saitejaswi06/Buck-Boost-Converter/buck_boost_report.pdf

Objective:
Design, fabrication, implementation of a 150 W, 100 V to 230 V and 100 V to 50V, 20 kHz Buck-Boost converter.
Vin = 100V
Vo = (Vin x D )/(1-D)
Step up from 100 V to 230 V ➔ D=23/33=69.7% Step down from 100V to 50V ➔ D=1/3=33.33%

Component Design

Component | Value | Voltage rating | Current rating
Inductor | 4 mH | | 5A
Capacitor | 20uF | 250V
Switch | MOSFET IRF740 | 400V | 10A
Diode | MUR860 | Vr=600V, Vf=1.5V | If=8A, Ir=10uA

Simulation and component selection:
- Simulation-based verification of the component ratings is done to ensure feasibility before fabrication.
- identified key components, including MOSFETs, Diodes, Inductors, and Capacitors, based on desired voltage and current ratings.
- Circuit layout using MATLAB feasibility before fabrication

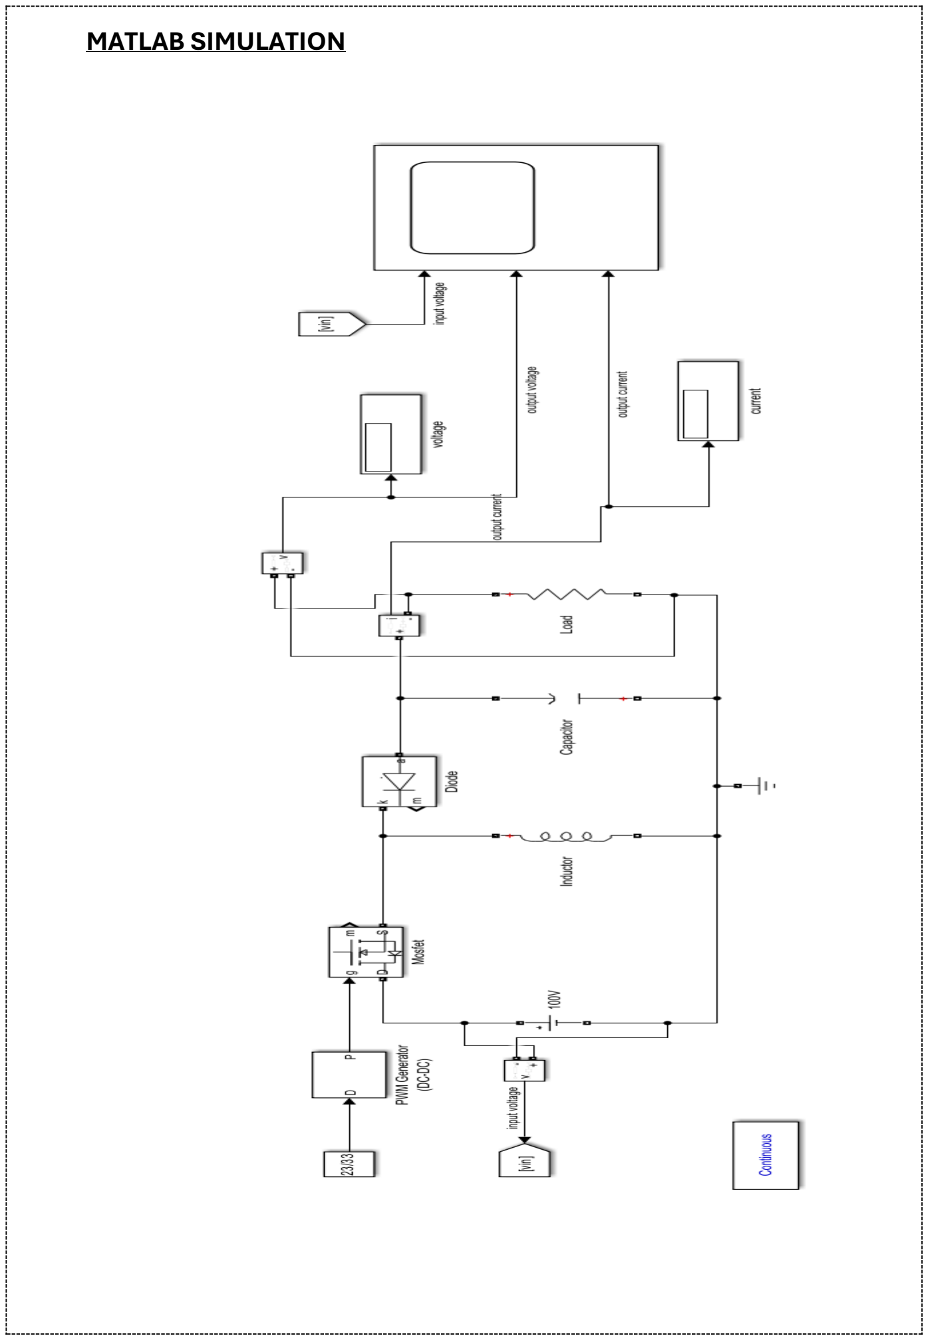
[picture p1: page 2]

MATLAB SIMULATION

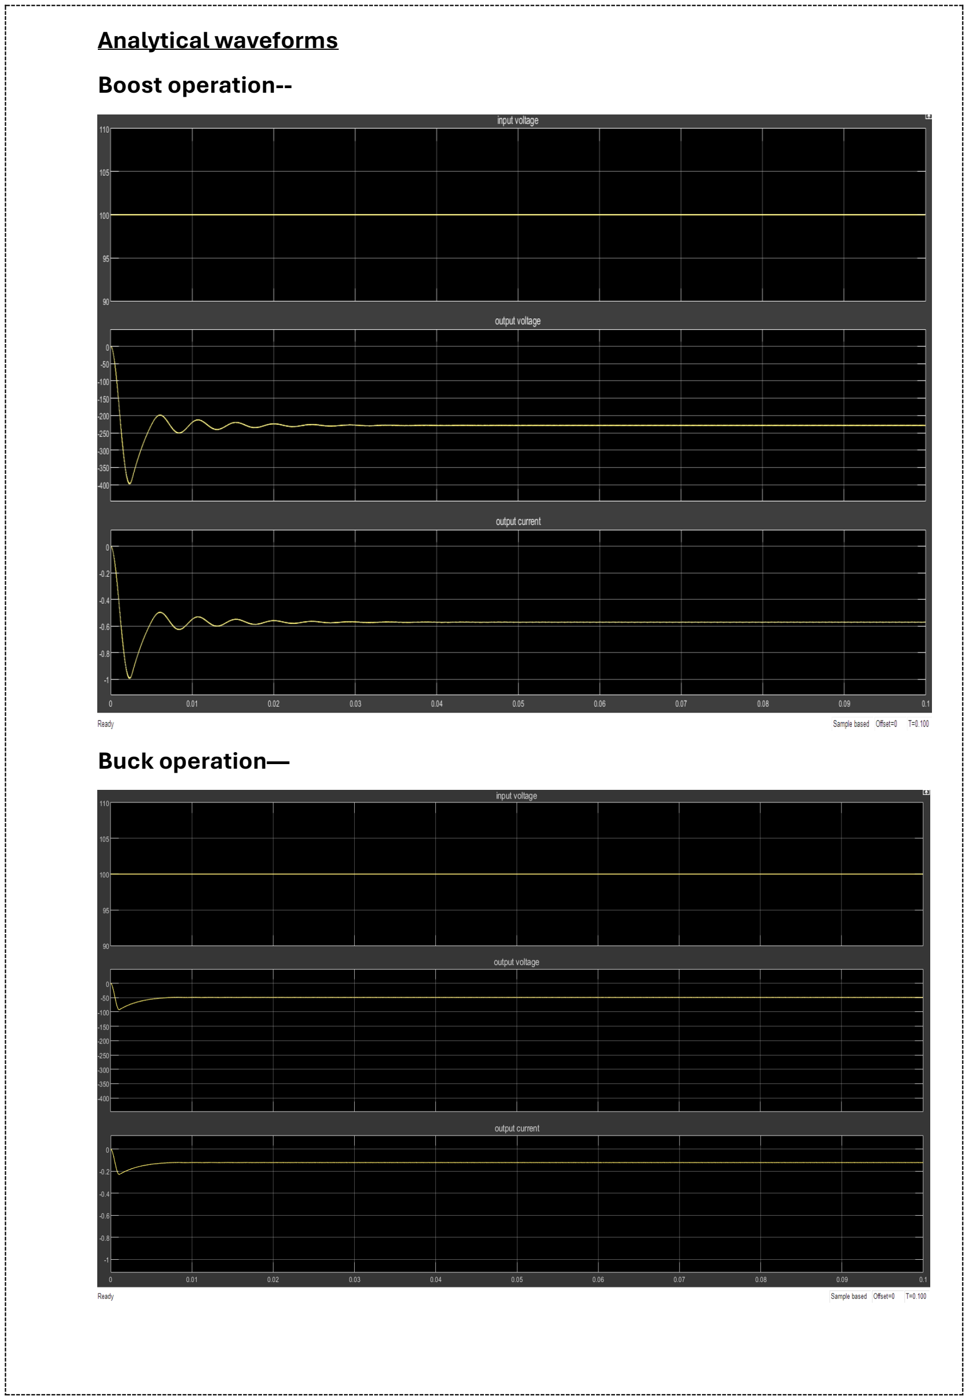
[picture p2: page 3]

Analytical waveforms
Boost operation--

Buck operation—

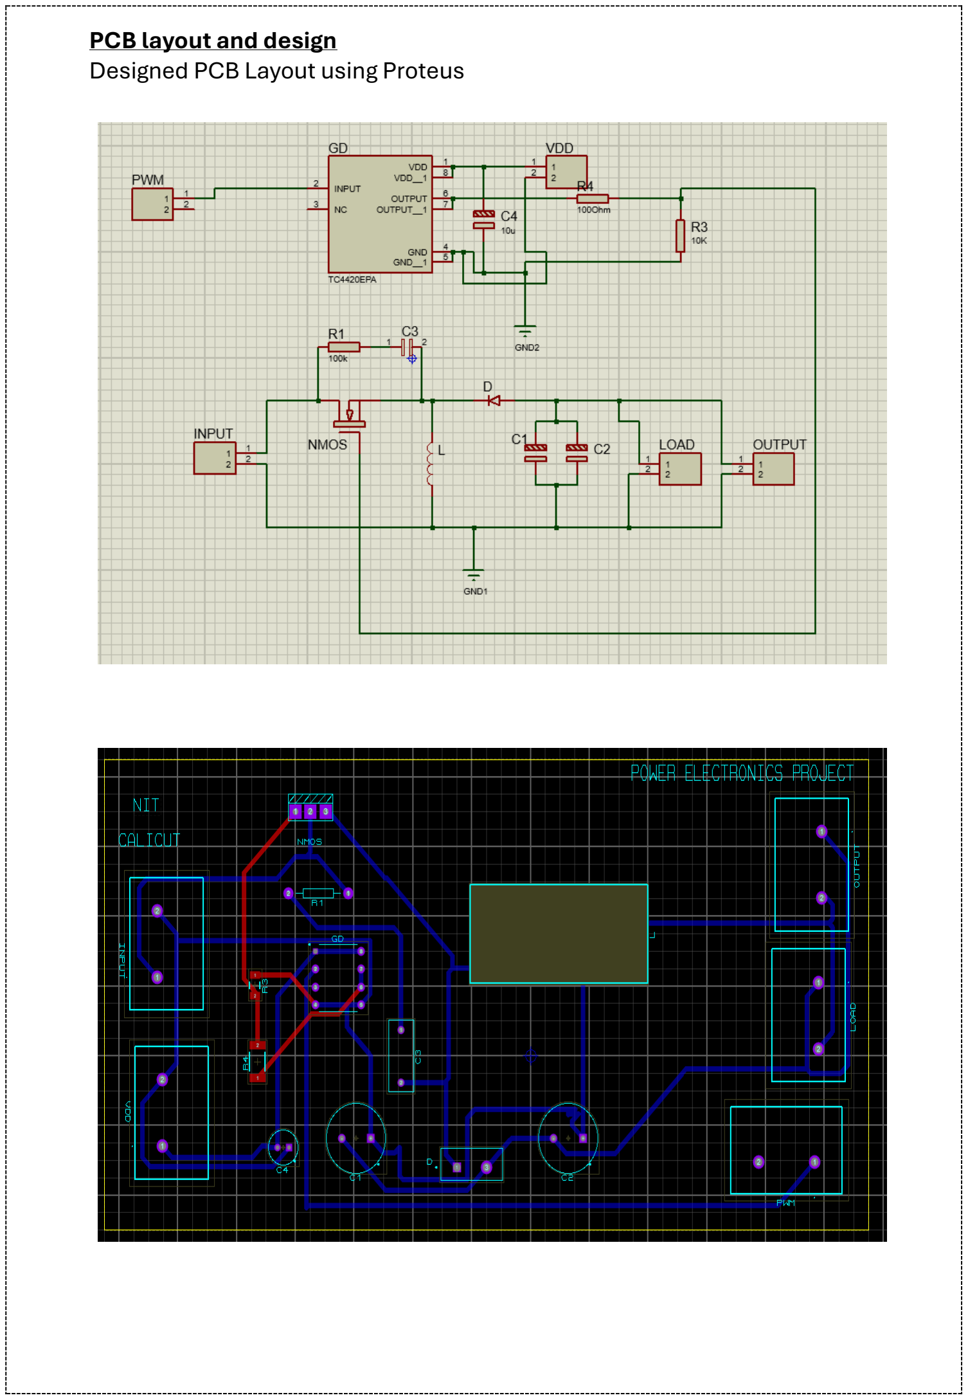
[picture p3: page 4]

PCB layout and design
Designed PCB Layout using Proteus

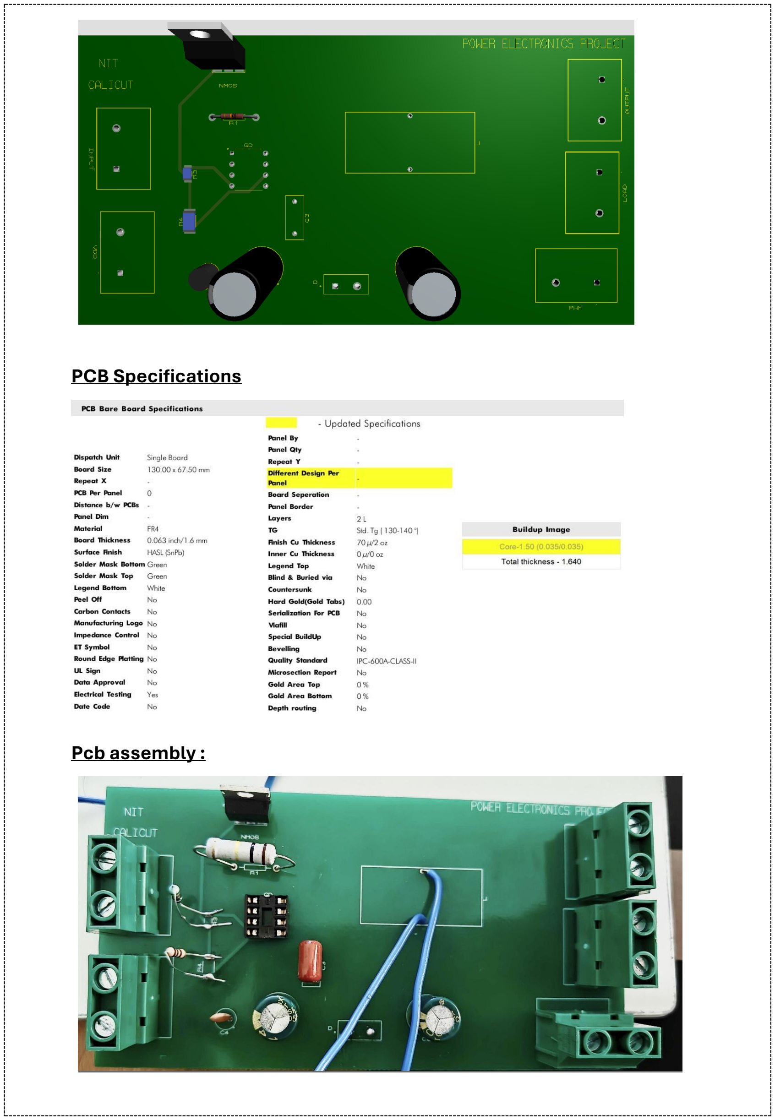
[picture p4: page 5]

PCB Specifications

Pcb assembly :

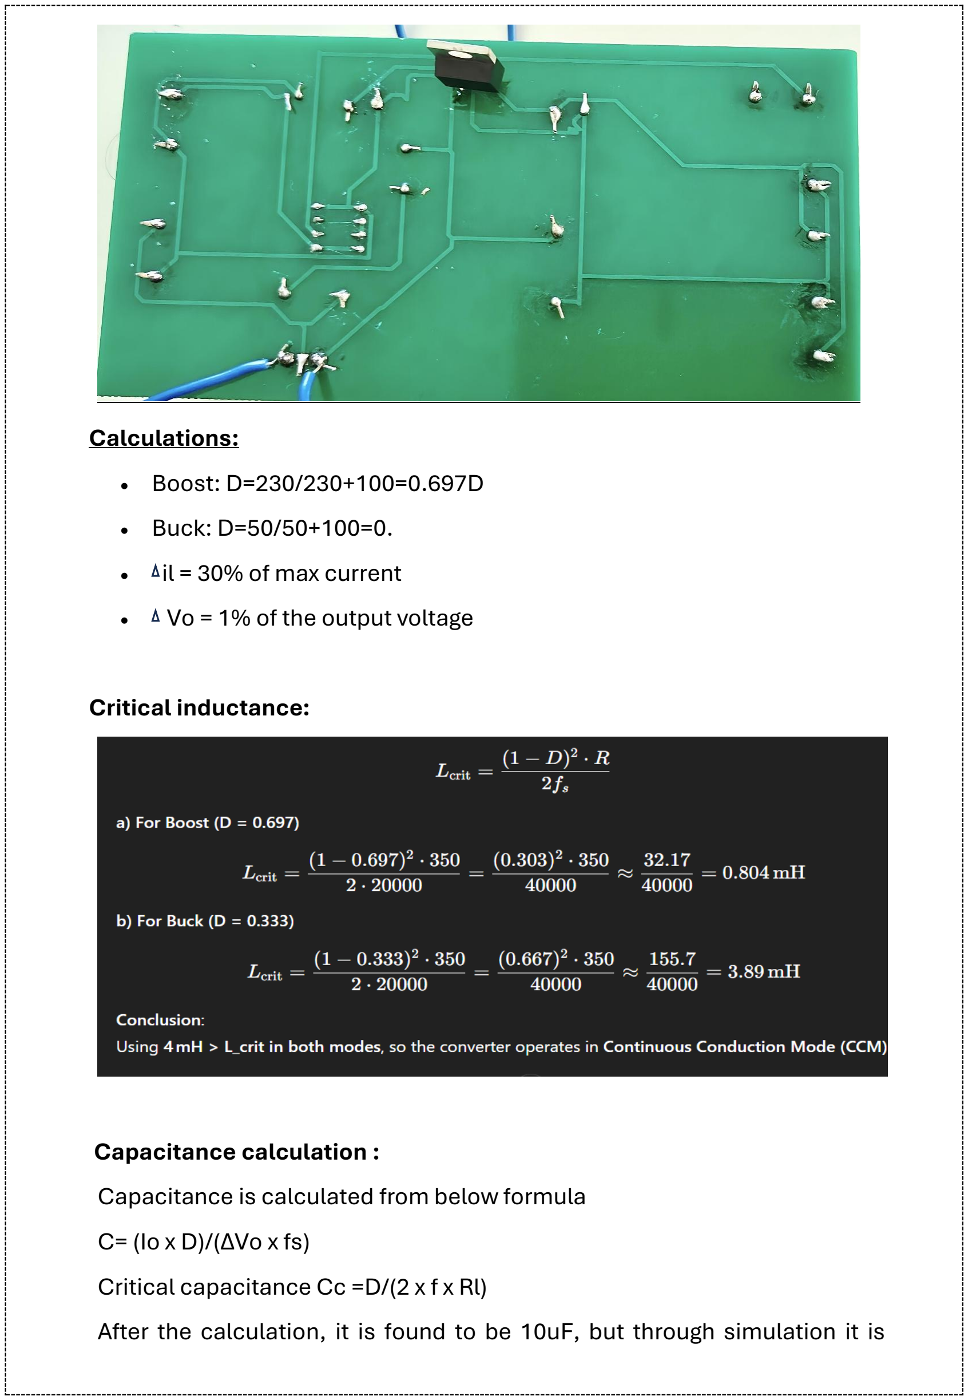
[picture p5: page 6]

Calculations:
- Boost: D=230/230+100=0.697D
- Buck: D=50/50+100=0.
- il = 30% of max current
- Vo = 1% of the output voltage

Critical inductance:

Capacitance calculation :
Capacitance is calculated from below formula
C= (Io x D)/(ΔVo x fs)
Critical capacitance Cc =D/(2 x f x Rl)
After the calculation, it is found to be 10uF, but through simulation it is chosen to be 20uF for better accuracy

Component Ordering:
NMOS | -IRF740
Diode | -MUR860
Gate Driver -TLP250
RC snubber -100kΩ(carbon film) + 0.1uF (ceramic capacitor)
Inductor | - 4mH
Capacitor | - 20uf, 400v(electrolytic capacitors)
Load resistor - 350Ω

Micro Controller for gate pulse:
Arduino Uno R3:
- Used Timer1 in Phase Correct PWM mode.
- PWM frequency ~20 kHz.
- Oscilloscope used to verify PWM pulse width and frequency.
- Generated pulses at output pins 9 and 10
Code for pulse generation:
void setup() {
// Set D9 and D10 as output
pinMode(9, OUTPUT);
pinMode(10, OUTPUT);

// Stop Timer1
TCCR1A = 0;
TCCR1B = 0;
TCNT1 = 0;

// Set Fast PWM mode with ICR1 as TOP
// WGM13:WGM10 = 14 => Fast PWM with ICR1 as TOP
TCCR1A |= (1 << COM1A1) | (1 << COM1B1); // Non-inverting mode
TCCR1A |= (1 << WGM11);
TCCR1B |= (1 << WGM12) | (1 << WGM13);

// No prescaling (prescaler = 1)
TCCR1B |= (1 << CS10);

// TOP value for 20kHz PWM frequency
ICR1 = 799; // f_PWM = 16MHz / (1 * (1 + 799)) = 20kHz

// Set duty cycles
OCR1A = (ICR1 * 23) / 33; // BOOST duty on D9
OCR1B = (ICR1 * 5) / 15; // BUCK duty on D10

}
void loop() {
}

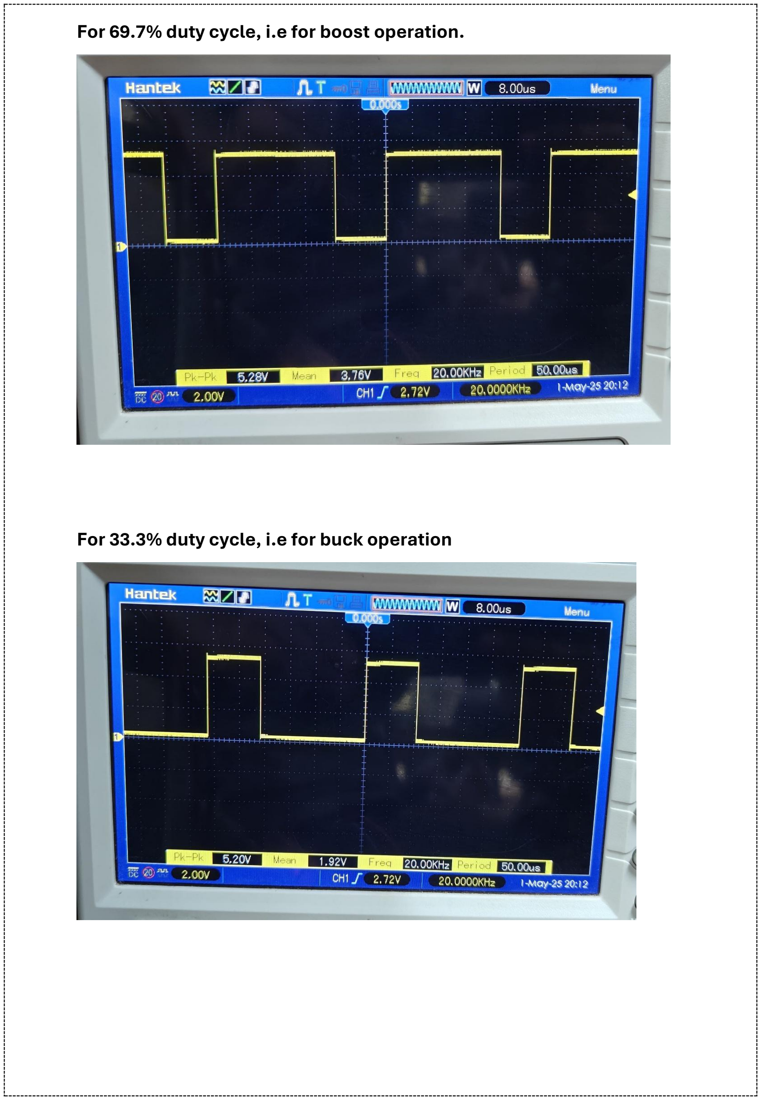
[picture p6: page 8]

For 69.7% duty cycle, i.e for boost operation.

For 33.3% duty cycle, i.e for buck operation

Gate driver design
To drive the IRF740 as a high-side MOSFET, a 15 V gate signal was required— beyond the 5 V logic level provided by the Arduino. The TLP250, an opto-isolated gate driver, was chosen to safely translate 5 V logic to 15 V while providing necessary isolation between the control and power circuits,
making | it | ideal | for | this | high-voltage | application.

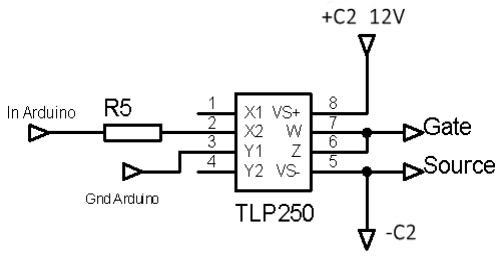
[picture p7: figure]

Gate Resistor (Rg)
Usually 1 resistor per gate – used between the TLP250 output and the MOSFET gate.
Rg=Vdrive/Igate
It is chose to be 100 Ω for reduced EMI losses and proper switching speed

Pull-Down Resistor (Rpd)

Connected between the Gate and Source of the MOSFET.

Typically 10kΩ is used

Bootstrap Capacitor (Cb)
If you're driving a high-side MOSFET (like in a half-bridge), the bootstrap capacitor is used to provide gate voltage above the source.

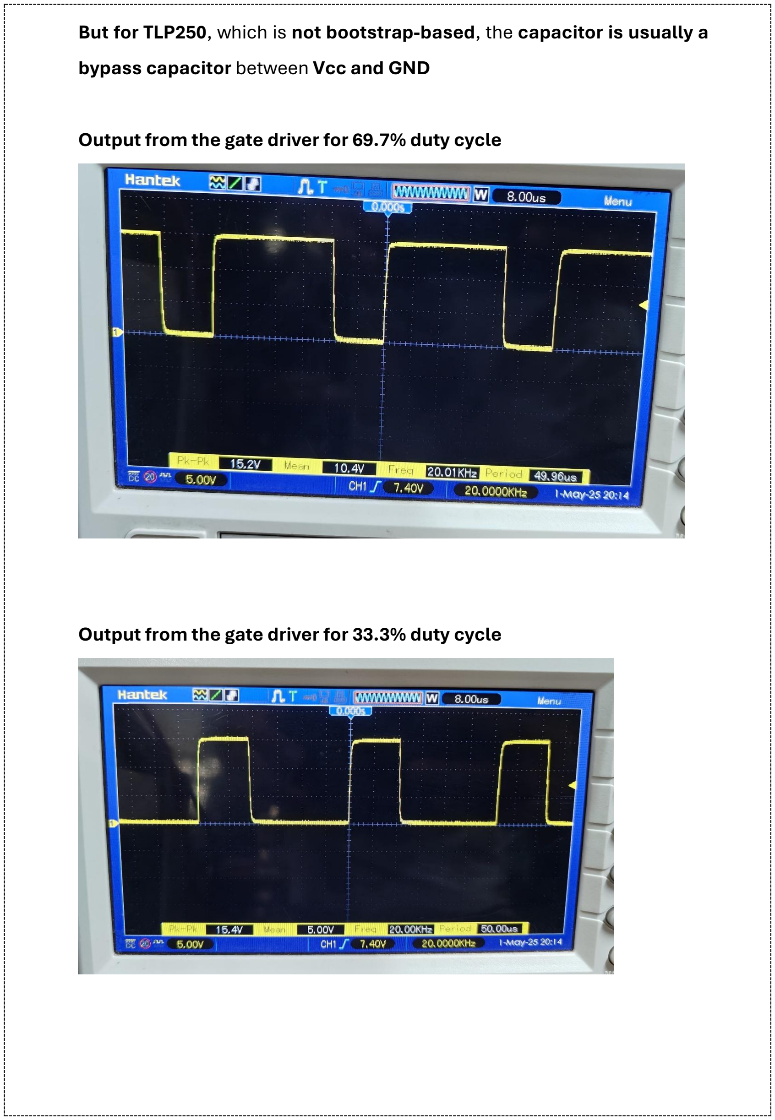
[picture p8: page 10]

But for TLP250, which is not bootstrap-based, the capacitor is usually a bypass capacitor between Vcc and GND

Output from the gate driver for 69.7% duty cycle

Output from the gate driver for 33.3% duty cycle

Inductor Design and Fabrication :
Objective:
Design and fabricate a 4 mH inductor suitable for use in a buck-boost converter operating around 100V input, with capability for both step-up and step-down modes.
L=(μ0⋅μr⋅A⋅N^2)/l

### 1. Core Selection:

Core Type: EE55 ferrite core (MnZn material) chosen for high-frequency performance and minimal core losses.
- Core Parameters:
- A(Effective Area): ~1.5 cm²
- L(Magnetic Path Length): ~8.5 cm
- B: ~0.35 T
- µr: ~2000 (assumed for gapped ferrite)

### 2. Inductance Calculation:

- Target Inductance (L): 4 mH
- Frequency: ~20 kHz
- Estimated Turns (N): ~85–100 turns (adjusted empirically based on actual inductance measured using LCR meter)
- Wire: AWG 20 enameled copper wire (current rating ~1.5–2A continuous)

### 3. Saturation Current Check:

With the gapped core, a saturation current of around 1.5–2 A was achieved, which was within expected limits for the converter's operation.

### 4. Fabrication:

- Winding: 90 turns of AWG20 wire.

### Result:

Boost operation

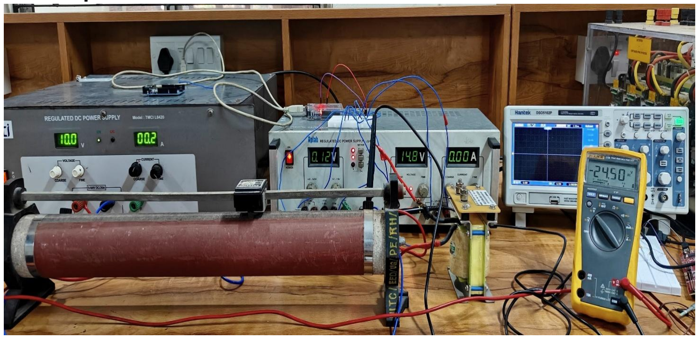
[picture p9: figure]
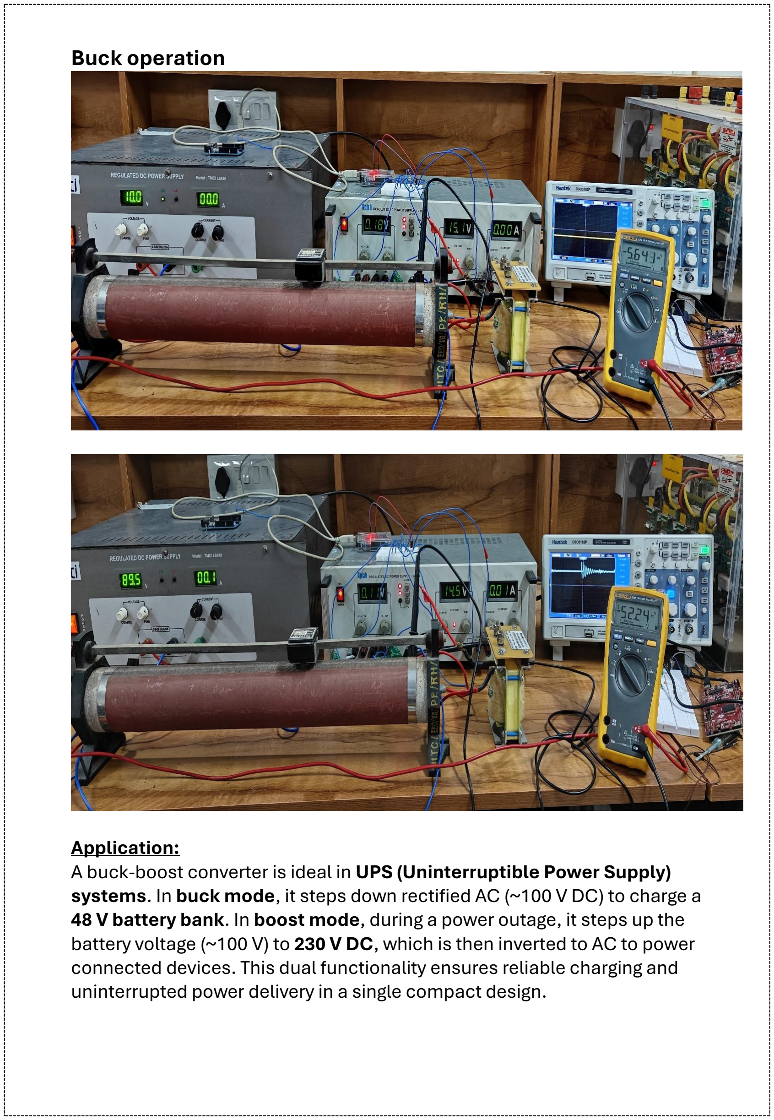
[picture p10: page 12]

Buck operation

Application:
A buck-boost converter is ideal in UPS (Uninterruptible Power Supply) systems. In buck mode, it steps down rectified AC (~100 V DC) to charge a

### 48 V battery bank. In boost mode, during a power outage, it steps up the

battery voltage (~100 V) to 230 V DC, which is then inverted to AC to power connected devices. This dual functionality ensures reliable charging and uninterrupted power delivery in a single compact design.

Conclusion:
This project successfully demonstrates a buck-boost converter capable of regulating output voltage under varying input conditions using an IRF740 MOSFET driven by the isolated TLP250 gate driver. The converter design, including calculated inductor and capacitor values, ensures efficient energy conversion with acceptable ripple levels. Its practical relevance is evident in renewable energy systems and other applications requiring stable voltage from variable power sources.

--------------------------------------THE END--------------------------------------------
